Doufless1/MONO/cad/stl/A1_looks_front_half.stl

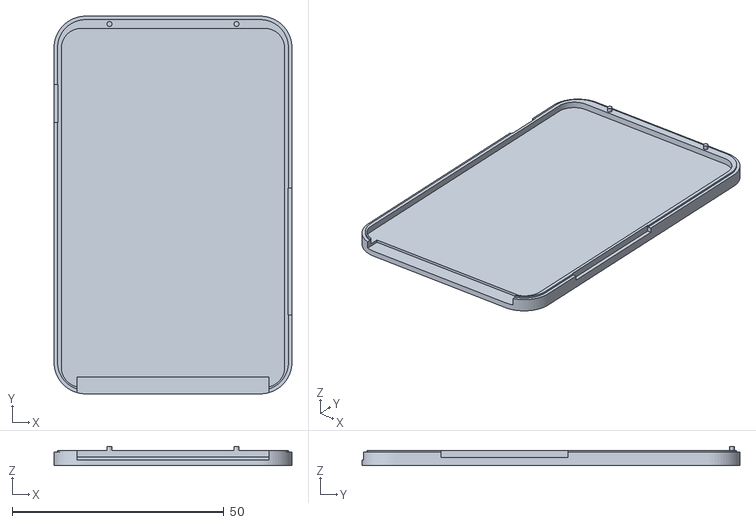
[picture p11: CAD file, 2026-10-14]
cad/stl/A1_looks_front_half.stl
56.2 x 89.2 x 4.60
