Doufless1/MONO/cad/stl/B3_component_tray.stl

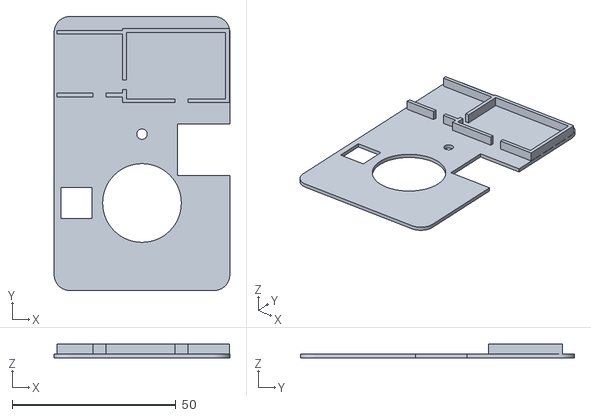
[picture p12: CAD file, 2026-10-14]
cad/stl/B3_component_tray.stl
53.6 x 83.6 x 4.20
