Doufless1/MONO/cad/stl/A2_looks_back_half.stl

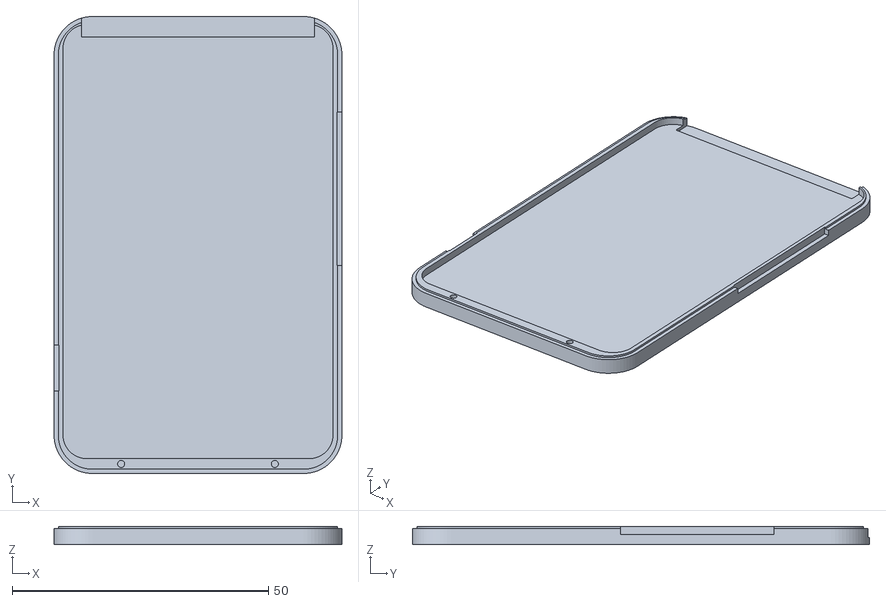
[picture p13: CAD file, 2026-10-14]
cad/stl/A2_looks_back_half.stl
56.2 x 89.2 x 3.60
