Doufless1/MONO/cad/stl/A4_display_card.stl

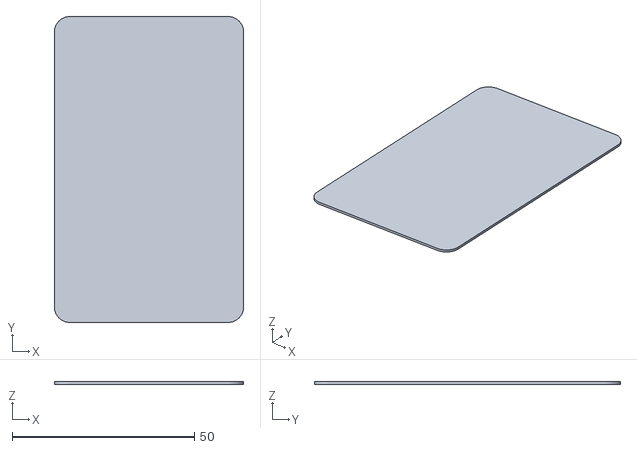
[picture p14: CAD file, 2026-10-14]
cad/stl/A4_display_card.stl
52.0 x 84.0 x 0.7
