Doufless1/MONO/cad/stl/B2_works_front_electronics.stl

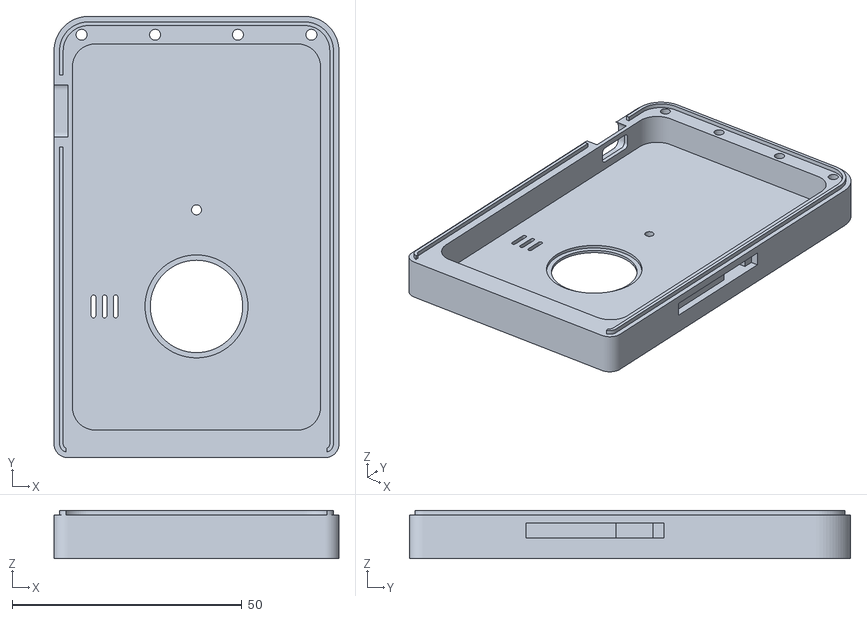
[picture p15: CAD file, 2026-10-14]
cad/stl/B2_works_front_electronics.stl
62.0 x 96.0 x 10.5
