Doufless1/MONO/cad/stl/B1_works_back_cards.stl

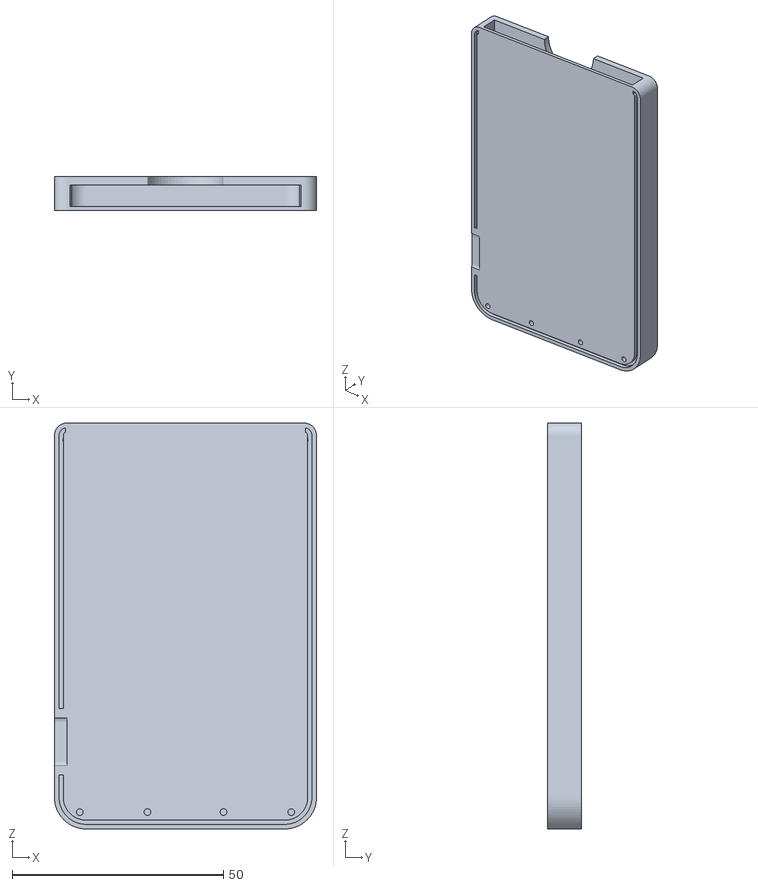
[picture p16: CAD file, 2026-10-14]
cad/stl/B1_works_back_cards.stl
62.0 x 8.06 x 96.0
