Doufless1/MONO/cad/stl/A3_spring_clip.stl

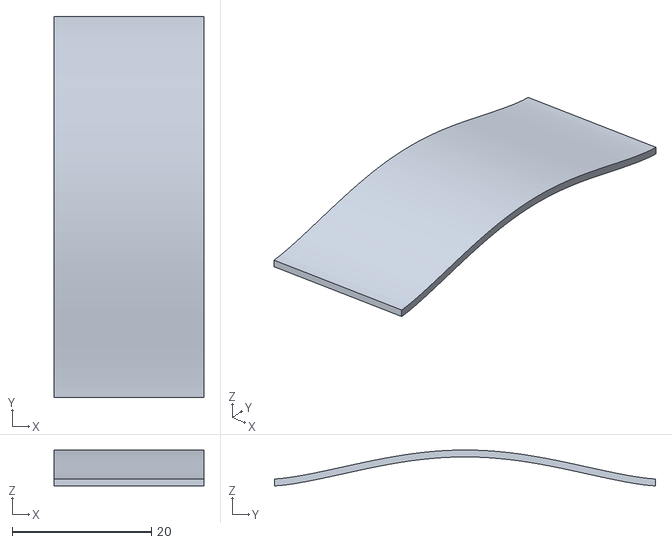
[picture p17: CAD file, 2026-08-22]
cad/stl/A3_spring_clip.stl
21.5 x 54.8 x 5.17
