Doufless1/MONO/sim/mocks/Arduino.h

/* Arduino.h - host mock.  Virtual clock, recorded I/O.
   Everything the firmware does to a pin is recorded so a test can assert on
   physical behaviour (servo angle, beeps, LED) without a board attached. */
#ifndef MOCK_ARDUINO_H
#define MOCK_ARDUINO_H

#include <cstdint>
#include <cstdio>
#include <cstring>
#include <cstdarg>
#include <cstdlib>
#include <cmath>
#include <string>
#include <vector>

#define HIGH 1
#define LOW  0
#define INPUT  0
#define OUTPUT 1
#define AR_INTERNAL_3_0 3

/* Pin macros the Seeed XIAO nRF52840 variant defines before the sketch's own
   code runs. They are mirrored here so a sketch macro that collides with one
   fails this build (-Werror) instead of only warning on the board, where it
   would also quietly re-point LED_BUILTIN. v2's PIN_LED did exactly that. */
#define LED_RED     (11)
#define LED_BLUE    (12)
#define LED_GREEN   (13)
#define PIN_LED     (LED_RED)
#define LED_BUILTIN (PIN_LED)
#define VBAT_ENABLE (14)
#define PIN_VBAT    (32)

/* Same idea for the C library: glibc's <limits.h> defines LINE_MAX (POSIX,
   2048), MinGW's does not, so a sketch macro named LINE_MAX built on Windows
   and broke CI on Linux. Defined here, it breaks everywhere. */
#ifndef LINE_MAX
#define LINE_MAX 2048
#endif

// ------------------------------------------------------------ the clock --
extern uint32_t g_millis;
inline uint32_t millis() { return g_millis; }

/* Blocking == time passes. The test harness leaves g_sleepHook null so a
   6-second relock costs nothing; the interactive simulator points it at a real
   sleep so the wallet behaves at wall-clock speed for a human at the app. */
extern void (*g_sleepHook)(uint32_t);
inline void delay(uint32_t ms) {
  if (g_sleepHook) g_sleepHook(ms);
  g_millis += ms;
}

// ------------------------------------------------------------- recorders --
// A beep's ms is filled in by noTone(); 0 while it is still sounding.
struct Beep { uint16_t freq; uint32_t ms; uint32_t at; };
extern std::vector<Beep>        g_beeps;
extern bool                     g_buzzerOn;
extern std::vector<int>         g_servoWrites;
extern std::vector<std::string> g_out;      // every line the firmware emitted
extern int   g_pinState[64];
extern float g_vbatRaw;

// ---------------------------------------------------------------- gpio ----
inline void pinMode(int, int) {}
inline void digitalWrite(int pin, int v) { if (pin < 64) g_pinState[pin] = v; }
int  digitalRead(int pin);                 // defined by the harness
inline void analogReference(int) {}
inline void analogReadResolution(int) {}
inline int  analogRead(int) { return (int)g_vbatRaw; }

inline void tone(int, unsigned int f, unsigned long ms = 0) {
  Beep b = { (uint16_t)f, (uint32_t)ms, g_millis };
  g_beeps.push_back(b);
  g_buzzerOn = true;
}
inline void noTone(int) {
  if (g_buzzerOn && !g_beeps.empty() && g_beeps.back().ms == 0)
    g_beeps.back().ms = g_millis - g_beeps.back().at;
  g_buzzerOn = false;
}

template <typename T, typename L, typename H>
inline T constrain(T v, L lo, H hi) { return v < (T)lo ? (T)lo : (v > (T)hi ? (T)hi : v); }

// -------------------------------------------------------------- Serial ----
struct MockSerial {
  std::vector<char> in;
  size_t rd = 0;
  operator bool() const { return true; }
  void begin(uint32_t) {}
  int  available() { return (int)(in.size() - rd); }
  int  read() { return rd < in.size() ? in[rd++] : -1; }
  void feed(const std::string &s) { for (char c : s) in.push_back(c); }

  // A real serial port is a byte stream: print() accumulates, println()
  // terminates the line. Modelling that is what makes "R502 online, templates: 0"
  // arrive as one assertable line instead of two fragments.
  std::string pending;
  void flush_(const std::string &tail) { g_out.push_back(pending + tail); pending.clear(); }

  void println(const char *s)   { flush_(s); }
  void println()                { flush_(""); }
  void println(int v)           { flush_(std::to_string(v)); }
  void println(unsigned v)      { flush_(std::to_string(v)); }
  void println(long v)          { flush_(std::to_string(v)); }
  void println(unsigned long v) { flush_(std::to_string(v)); }
  void println(float v, int d)  { char b[32]; snprintf(b, sizeof b, "%.*f", d, v); flush_(b); }
  void print(const char *s)     { pending += s; }
  void print(int v)             { pending += std::to_string(v); }
  void print(unsigned v)        { pending += std::to_string(v); }
  void print(char c)            { pending += c; }
  void print(float v, int d)    { char b[32]; snprintf(b, sizeof b, "%.*f", d, v); pending += b; }
};
extern MockSerial Serial;
extern MockSerial Serial1;

#endif
