Doufless1/MONO/(commit log)

2026-08-22 Baseline: firmware v2, companion app, parametric CAD
    [A1_looks_front_half.stl, A2_looks_back_half.stl, A3_spring_clip.stl, B1_works_back_cards.stl, B2_works_front_electronics.stl, B3_component_tray.stl]
2026-08-22 tests: host harness that runs the firmware without hardware
    Compiles mono_firmware.ino unmodified against mock Arduino/BLE/R502/IMU/
    LittleFS and drives it on a virtual clock. 110 assertions covering the
    command protocol, settings clamping and persistence, the unlock/lockout/
    tamper/leash/enrol state machines, and the Find My advertisement layout.
2026-08-22 tests: CAD geometry suite measured off the generated meshes
    71 checks on watertightness, envelope conformance, half-to-half mating,
    card and component fit, fastener placement and sensor retention, plus a
    regeneration pass that proves whether the CONFIG block is actually live.
    Finds: N_CARDS_B is dead (cav_d computed, never used), the card mouth is
    narrower than an ISO card in both models, the B3 servo pocket leaves the
    16 mm servo dimension vertical in a 7 mm bay, and two stale comments.
2026-08-22 tests: wallet simulator, app bridge, runner and findings
    mono_sim.cpp runs the same firmware at wall-clock speed over a line
    protocol; app_sim_server.py serves mono_app/index.html unmodified with a
    navigator.bluetooth shim wired to it, so the real app UI can be driven
    against real firmware logic with no board attached.
    Shared mock globals moved to mocks/mock_impl.h so the simulator and the
    test suite cannot drift. FINDINGS.md records what the run turned up.
    [Arduino.h, mock_impl.h, test_firmware.cpp]
2026-08-23 app: rebuild the companion as the ONYX phone UI
    Replaces the bench-tool UI with the ONYX design, screen for screen, wired
    to the real wallet instead of the mockup's placeholder data.
    The design arrived as a Claude Design bundle: an x-dc template plus a
    DCLogic class whose renderVals() hardcoded "78%", "14 minutes ago", two
    invented fingerprints and a wallet called ONYX-4C1A. Every one of those
    bindings now comes from the firmware over Nordic UART. Rebuilt in plain
    JS rather than the mockup's React + Babel so the app stays a single
    offline file with no build step, and tests/app_sim_server.py keeps
    serving it unchanged.
    Screens: home, where it was, fingers, enrolment, settings, the four
    pres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
2026-08-23 findings: re-verify against the ONYX app rebuild
    A1 (stale UI after LOCK/UNLOCK/CLEAR) is fixed in the rebuild and confirmed
    at runtime against the simulator. Adds F5, the >1s main-loop stall during
    alarm and ring sequences, and notes the stray empty 'git' file.
2026-08-23 feat: add 3D model asset for mono-wallet prototype
2026-10-14 firmware: v3 - authenticated phones, nothing blocks, 21 bugs fixed
    v2 opened for any phone in radio range: UNLOCK, SET servolock and ENROLL
    needed no pairing. v3 adds a trust model. A factory-fresh wallet pairs its
    first phone at once; later phones need the owner's finger on the sensor;
    every connection answers a fresh 128-bit challenge with
    HMAC-SHA256(key, "MONO-AUTH-1" || nonce). The USB console, on the outside
    of the case, is trusted only while the wallet is unowned or for a minute
    after the owner's finger opened it.
    The loop is now a list of services on deadlines. Beeps come from a
    scheduled player, the servo detaches on a timer, tamper sampling runs on a
    fixed 50 Hz grid, and the LED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
    [Arduino.h, LSM6DS3.h, Servo.h, bluefruit.h]
2026-10-14 app: rebuild ONYX as tested modules, installable and offline-capable
    The single-file app is split into protocol.js (pure), crypto.js
    (WebCrypto), transport.js (Web Bluetooth), session.js (handshake,
    request/reply matching, reconnect with backoff), store.js, ui.js, demo.js
    and app.js, so everything that can be tested outside a browser is.
    17 issues fixed, among them: one GATT write at a time (Chrome refused the
    second of a STATUS and GET sent back to back); 20-byte chunks; the
    notification listener attached before notifications start; no "Open" on
    screen until the wallet says UNLOCK ok; "Never" for the walk-away alarm
    really switching it off; reconnecting by itself when the wallet comes
    back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
2026-10-14 cad: parametric rewrite with a digital mock-up; 17 defects fixed
    Every finding was measured off v1's own meshes first. Model A's halves
    could not close: the pin holes were cut into thin air. Model B's USB-C
    slot was blind behind a 0.5 mm membrane, 30 mm from the board; its latch
    slot was blind too; the cards and the electronics shared one open void;
    the mouth was narrower than a card; N_CARDS_B changed nothing.
    layout_b() is now the single source of truth, so features that must line
    up are computed from each other. cad/dmu.py assembles all 22 solids and
    checks 226 pairs for clashes, pushes a USB-C plug home (6.25 mm engaged),
    slides the cards out through the mouth, and traces the light, sou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
    [A1_looks_front_half.stl, A2_looks_back_half.stl, A3_spring_clip.stl, A4_display_card.stl, B1_works_back_cards.stl, B2_works_front_electronics.stl, B3_component_tray.stl]
2026-10-14 repo: README, docs, a live demo page, CI and Pages
    - README: renders, a GIF recorded from the live demo, the review in
    brief, and how to run everything.
    - docs/: the architecture, the v3 line protocol, the threat model
    (including what it does not stop), a build guide, and the engineering
    review with the reproduction and the pinning test for each finding.
    It supersedes FINDINGS.md, whose last version stays in 989a5dc.
    - site/: the project page. The real firmware runs in the tab, between
    the ONYX app and a three.js twin driven by the firmware's own outputs
    (servo angle, LED pin, buzzer, advertising interval), plus a CAD viewer.
    - CI: three firmware builds, a compile for the real XI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
2026-10-14 ci: fix the firmware and CAD jobs on Linux
    Firmware: config.h defined LINE_MAX, which glibc's <limits.h> already
    defines (POSIX, 2048). MinGW has no such macro, so the Windows build
    passed while all three -Werror builds on ubuntu failed with "'LINE_MAX'
    macro redefined". It is now CMD_LINE_MAX, and the mock Arduino.h defines
    LINE_MAX the way glibc does, so the collision fails on every platform.
    CAD: trimesh's ray casting (the access-path checks in cad/dmu.py) needs
    rtree, which was installed locally but missing from cad/requirements.txt.
    [Arduino.h, config.h, mono_firmware.ino]
